castor2018/Rhino-Pi-A1-VisionGuidedCar/接线图/小车装配图2.jpg

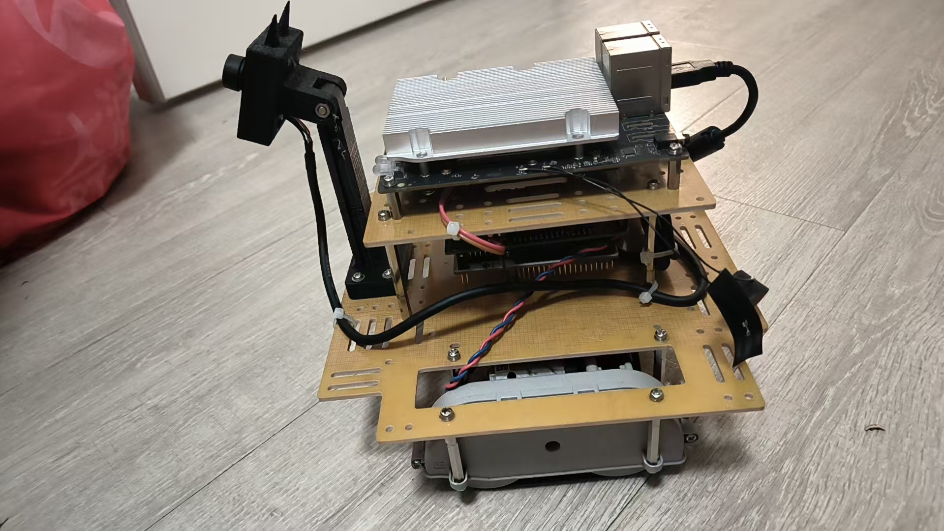
接线图/小车装配图2.jpg
