castor2018/Rhino-Pi-A1-VisionGuidedCar/接线图/STM32开发板.png

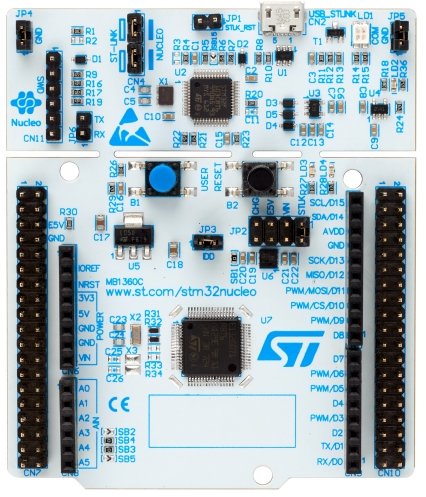
接线图/STM32开发板.png
