castor2018/Rhino-Pi-A1-VisionGuidedCar/接线图/摄像头.png

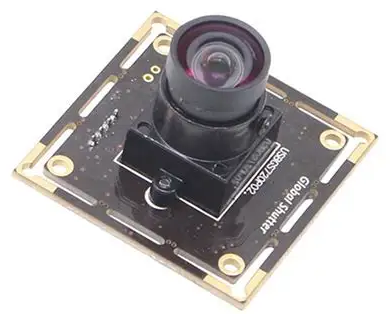
接线图/摄像头.png
