castor2018/Rhino-Pi-A1-VisionGuidedCar/接线图/犀牛派.png

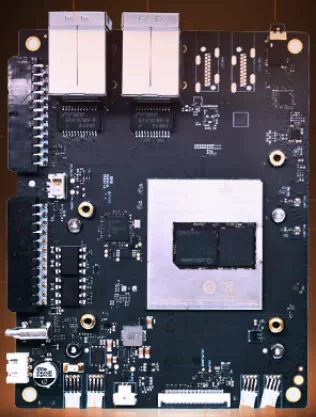
接线图/犀牛派.png
