castor2018/Rhino-Pi-A1-VisionGuidedCar/接线图/电机驱动板.png

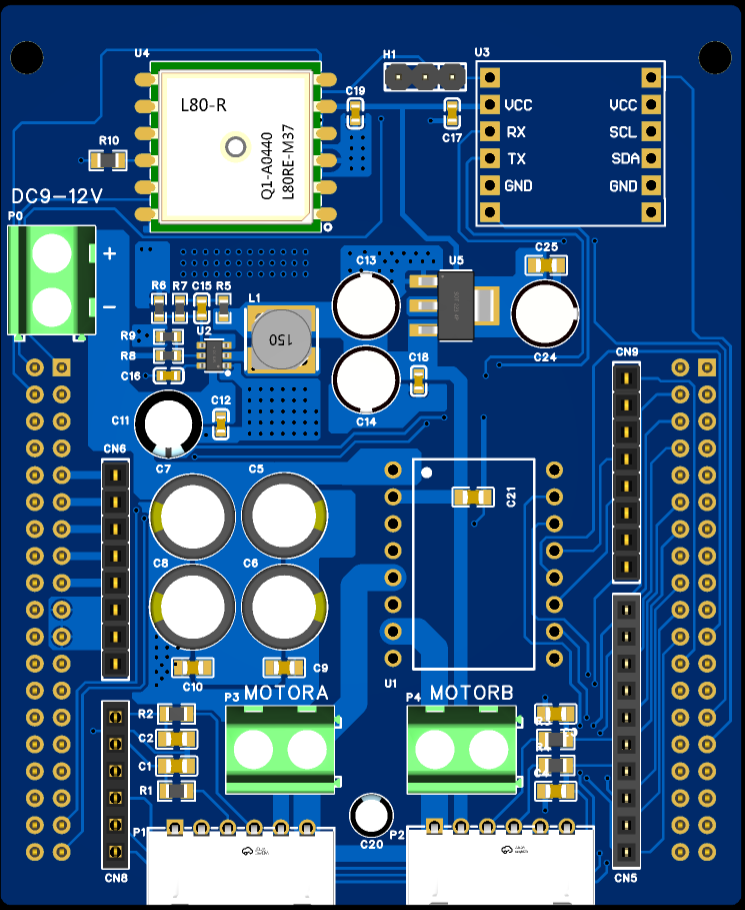
接线图/电机驱动板.png
