castor2018/Rhino-Pi-A1-VisionGuidedCar/接线图/电池png.png

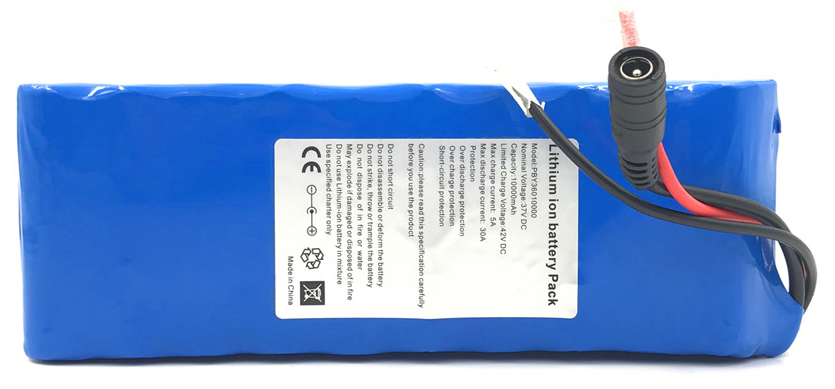
接线图/电池png.png
