castor2018/Rhino-Pi-A1-VisionGuidedCar/接线图/系统接线图.png

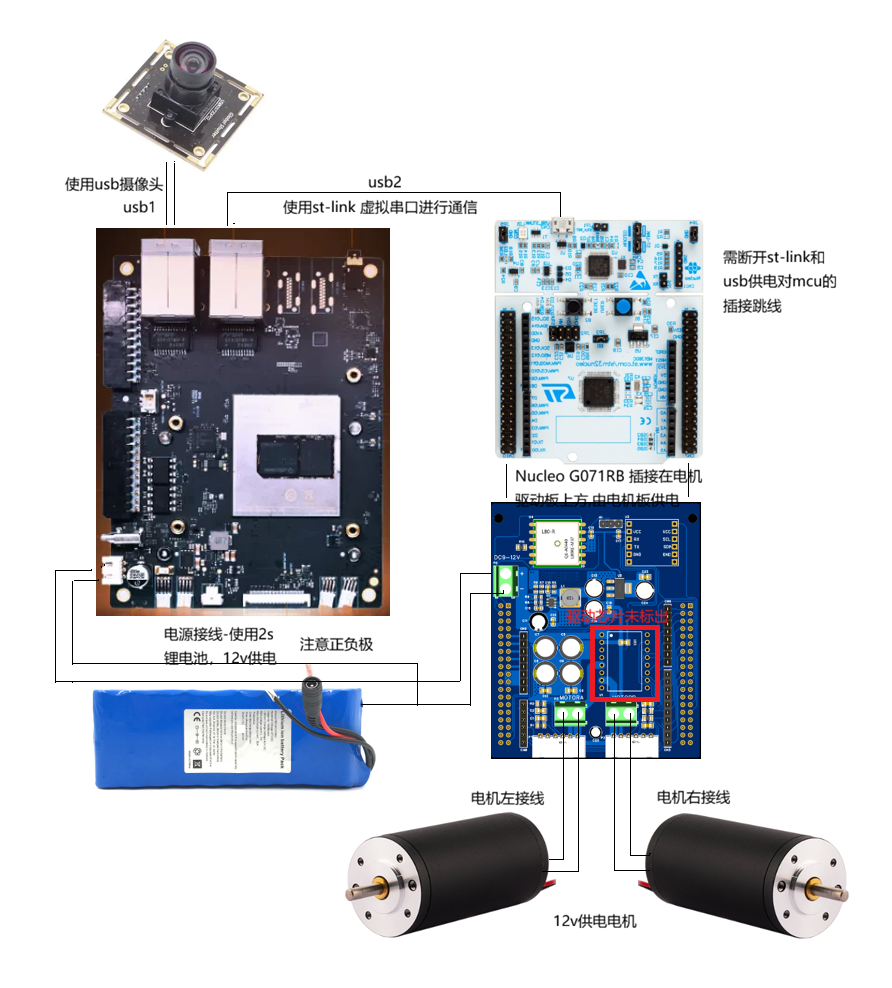
接线图/系统接线图.png
