castor2018/Rhino-Pi-A1-VisionGuidedCar/视觉控制算法程序/aid-Car/object_det/cover.png

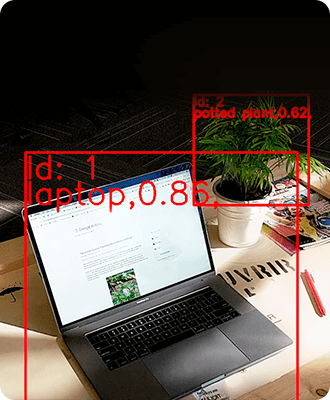
视觉控制算法程序/aid-Car/object_det/cover.png
