castor2018/Rhino-Pi-A1-VisionGuidedCar/视觉控制算法程序/aid-Car/plate_spot/img/6.jpg

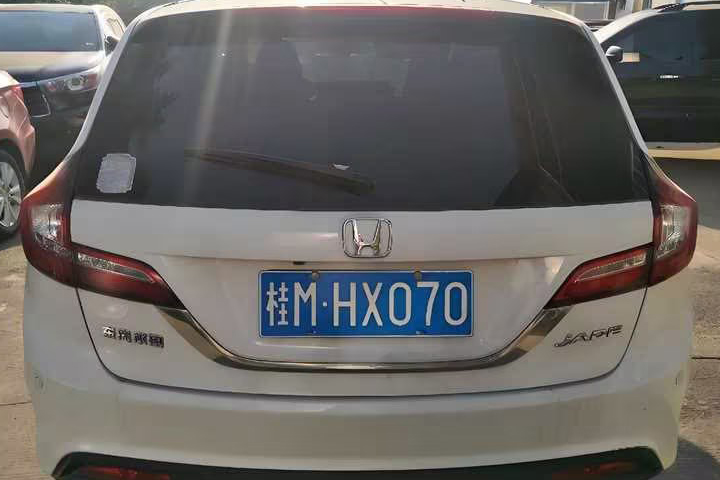
视觉控制算法程序/aid-Car/plate_spot/img/6.jpg
