castor2018/Rhino-Pi-A1-VisionGuidedCar/电机驱动板原理图/电机驱动板V1.0.xlsx

No. | Quantity | Comment | Designator | Footprint | Value
1 | 9 | 100nF | C1,C2,C3,C4,C9,C10,C21,C22,C25 | C0805 | 100nF
2 | 4 | 100uF | C5,C6,C7,C8 | CAP-TH_BD8.0-P3.50-D0.5-FD | 100uF
3 | 1 | 47uF/35V | C11 | CAP-TH_BD6.3-P2.50-D1.0-FD | 47uF/35V
4 | 5 | 100nF | C12,C16,C17,C18,C19 | C0603 | 100nF
5 | 3 | 22uF/25V | C13,C14,C24 | CAP-TH_BD6.3-P2.50-D0.6-FD | 22uF/25V
6 | 1 | 75pF | C15 | C0603 | 75pF
7 | 1 | 4.7uF | C20 | CAP-TH_BD4.0-P1.50-D0.8-FD | 4.7uF
8 | 1 | HDR-F_2.54_1x10P | CN5 | HDR-TH_10P-P2.54-V-F
9 | 2 | HDR-F_2.54_1x8P | CN6,CN9 | HDR-TH_8P-P2.54-V-F-1
10 | 2 | HC-PM254-8.5H-2x19PZ | CN7,CN10 | HDR-TH_38P-P2.54-V-F-R2-C19-S2.54
11 | 1 | HDR-F_2.54_1x6P | CN8 | HDR-TH_6P-P2.54-V-F
12 | 1 | HDR-M_2.54_1x3P | H1 | HDR-TH_3P-P2.54-V-M
13 | 1 | 10uH | L1 | IND-SMD_L5.7-W5.7 | 10uH
14 | 3 | KF127-5.08-2P | P0,P3,P4 | CONN-TH_P5.08_KF127-5.08-2P
15 | 2 | ZX-XH2.54-6PWZ | P1,P2 | CONN-TH_6P-P2.50_ZX-XH2.54-6PWZ
16 | 5 | 1kΩ | R1,R2,R3,R4,R10 | R0805 | 1kΩ
17 | 1 | 49.9R | R5 | R0603 | 49.9R
18 | 1 | 13.3K | R6 | R0603 | 13.3K
19 | 2 | 100K | R7,R9 | R0603 | 100K
20 | 1 | 500K | R8 | R0603 | 500K
21 | 2 | 0R | R11,R12 | R0603 | 0R
22 | 1 | tb6612驱动板 | U1 | tb6612电机驱动模块 | 淘宝
23 | 1 | TPS54302DDCR | U2 | TSOT-23-6_L2.9-W1.6-P0.95-LS2.8-BR
24 | 1 | JY-901 | U3 | JY-901 | 维特智能
25 | 1 | L80-R | U4 | GPSM-SMD_L80-R | 移远
26 | 1 | AMS1117-3.3 | U5 | SOT-223-3_L6.5-W3.4-P2.30-LS7.0-BR
