castor2018/Rhino-Pi-A1-VisionGuidedCar/材料清单.docx

犀牛派A1项目视觉跟随小车材料清单

序号 | 名称 | 型号 | 数量 | 单位 | 备注
1 | 视觉核心板 | 犀牛派A1 | 1 | 个 | 完成视觉算法
2 | 驱动核心板 | NUCELO-G071RB | 1 | 个 | 完成运动指令接收
3 | 电机驱动板 | | 1 | 个 | 接收驱动核心板指令驱动电机
4 | 履带式电机 | 12V | 1 | 对 | 淘宝
5 | USB摄像头 | DCXGW10模组-无畸变 | 1 | 个 | 杰锐微通
6 | 3S锂电池组 | 11.1V锂电池 3A | 1 | 个
7 | MicroUSB线 | | 1 | 个
8 | 框架板 | | 2 | 个 | 环氧树脂或亚克力
9 | M3-六棱柱 | | 8 | 个
10 | M3-六棱柱 | | 4 | 个
11 | M3-六棱柱 | | 4 | 个
12 | 摄像头支架 | | 1 | 套 | 3D打印件，可不用
13
14
15 | 扎带 | | | 个
16 | M3螺丝 | | | 若干
