castor2018/Rhino-Pi-A1-VisionGuidedCar/摄像头支架/摄像头支架.3mf

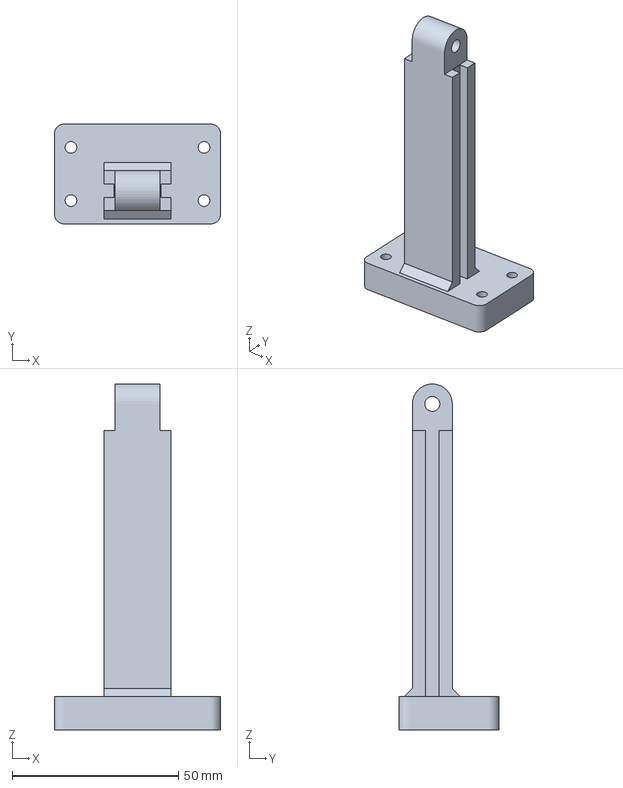
[picture p19: CAD file, 2026-09-28]
摄像头支架/摄像头支架.3mf
50.0 x 30.0 x 104.0 mm
