castor2018/Rhino-Pi-A1-VisionGuidedCar/小车框架基板/上板.STEP

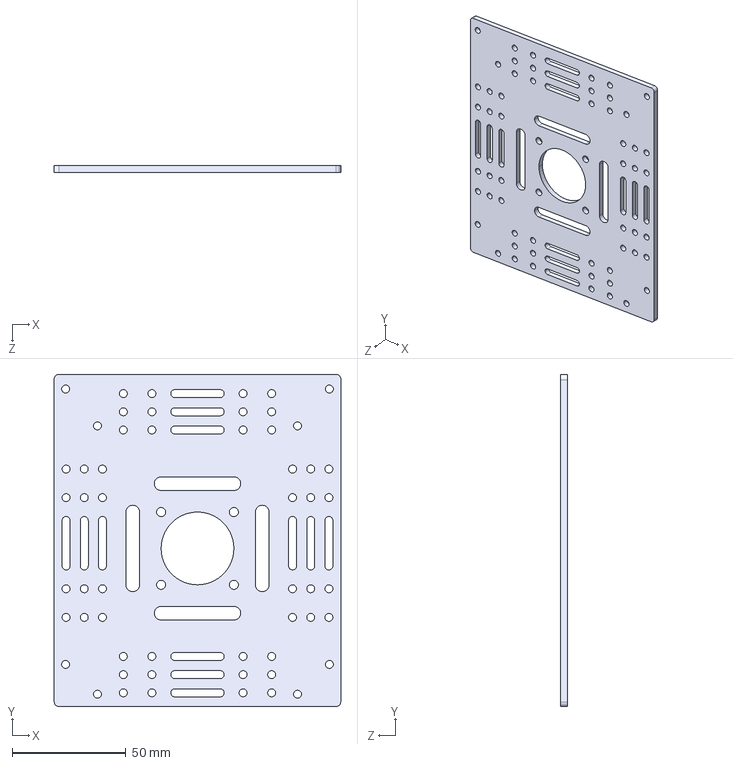
[picture p20: CAD file, 2026-09-28]
小车框架基板/上板.STEP
126.1 x 146.0 x 3.00 mm
