castor2018/Rhino-Pi-A1-VisionGuidedCar/摄像头支架/摄像头外壳.3mf

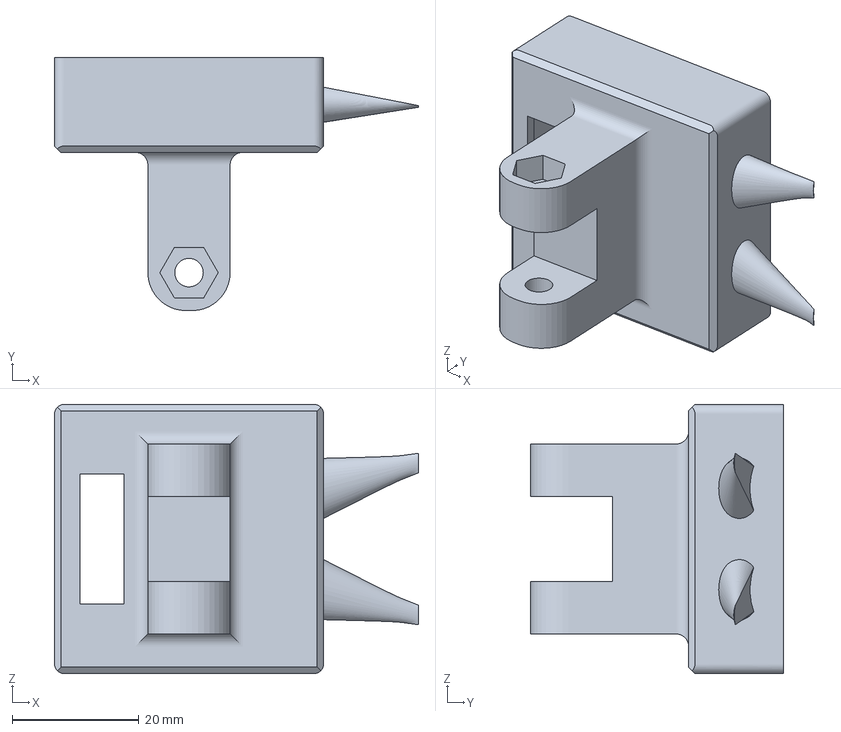
[picture p21: CAD file, 2026-09-28]
摄像头支架/摄像头外壳.3mf
57.5 x 40.0 x 42.5 mm
