castor2018/Rhino-Pi-A1-VisionGuidedCar/摄像头支架/摄像头顶盖.3mf

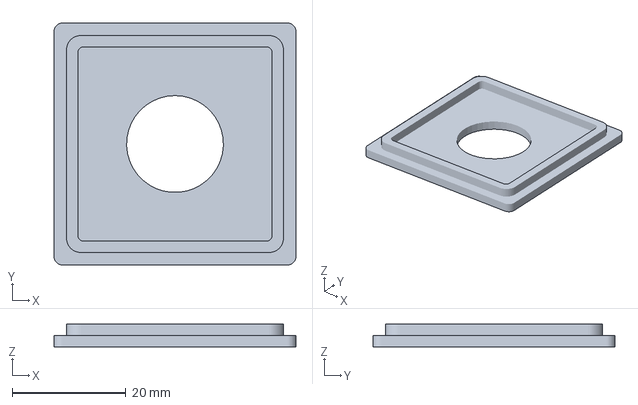
[picture p22: CAD file, 2026-09-28]
摄像头支架/摄像头顶盖.3mf
42.5 x 42.5 x 4.00 mm
