castor2018/Rhino-Pi-A1-VisionGuidedCar/小车框架基板/下板.STEP

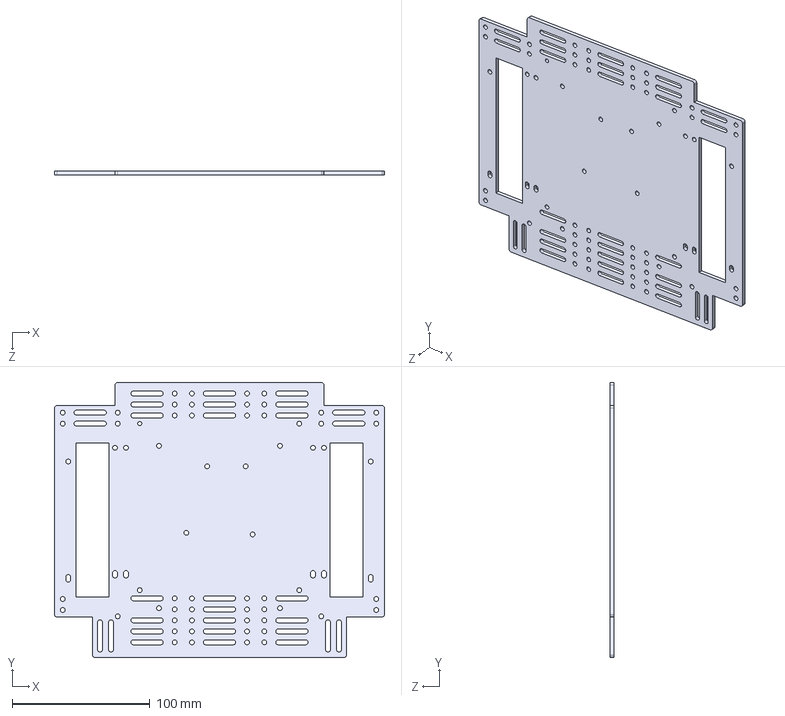
[picture p23: CAD file, 2026-09-28]
小车框架基板/下板.STEP
240.0 x 200.0 x 3.00 mm
