castor2018/Rhino-Pi-A1-VisionGuidedCar/(list of files, cad)

Other CAD files:
小车框架基板/下板_2004.dwg
小车框架基板/上板_2004.dwg
