castor2018/Rhino-Pi-A1-VisionGuidedCar/电机驱动板原理图/电机驱动板V1.0.pdf

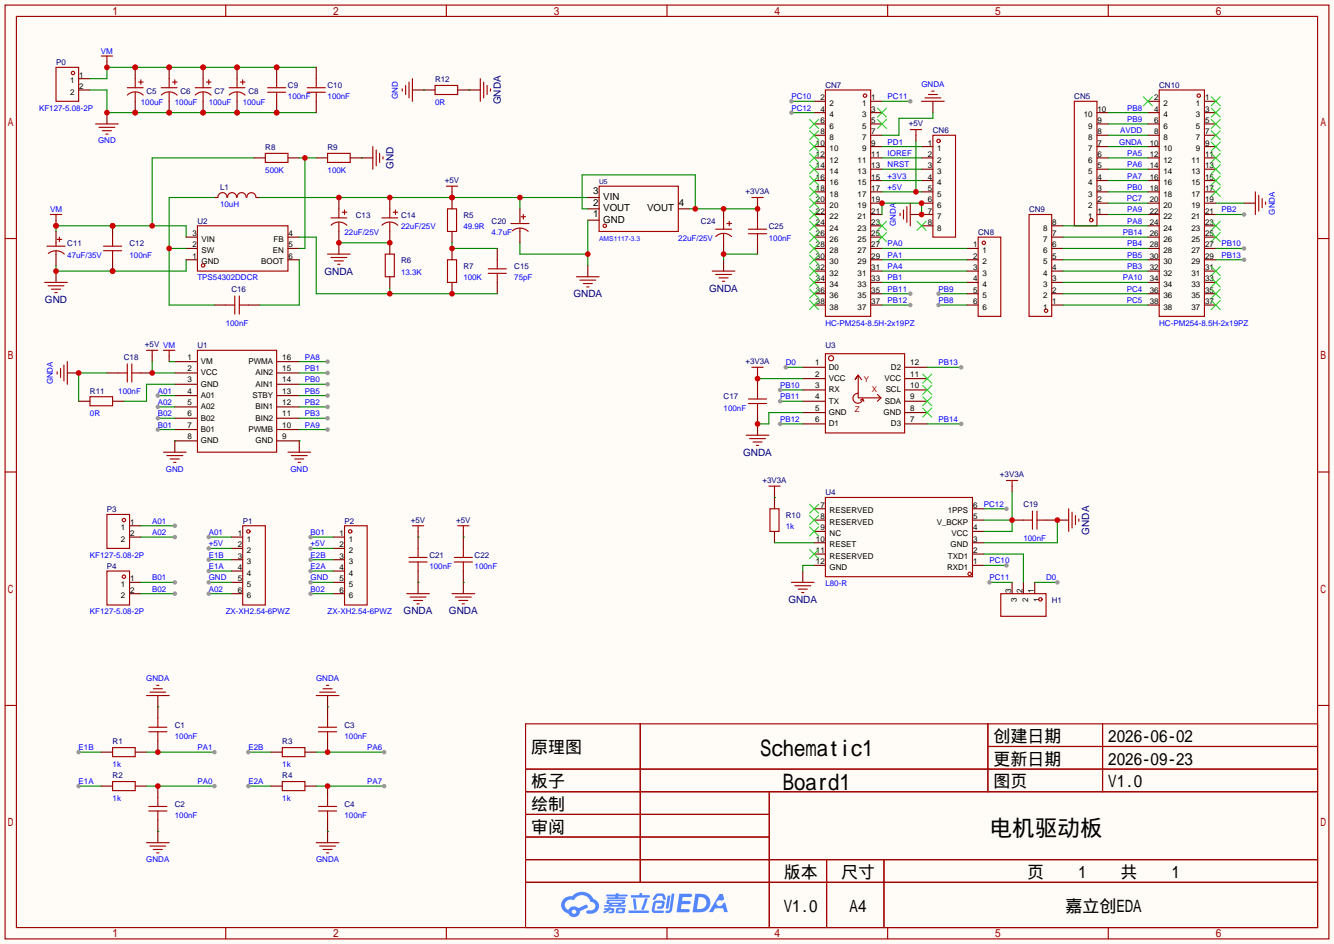
[picture p24: page 1]

原理图 | Schematic1 | 创建日期 | 2026-06-02

更新日期 | 2026-09-23

板子 | Board1 | 图页 | V1.0
绘制 | | 电机驱动板
审阅

V1.0 | A4 | 嘉立创EDA
