castor2018/Rhino-Pi-A1-VisionGuidedCar/电机驱动程序/diy_TrackCar/Core/Inc/main.h

#define MCO_Pin GPIO_PIN_0
#define MCO_GPIO_Port GPIOF
#define USART2_TX_Pin GPIO_PIN_2
#define USART2_TX_GPIO_Port GPIOA
#define USART2_RX_Pin GPIO_PIN_3
#define USART2_RX_GPIO_Port GPIOA
#define LED_GREEN_Pin GPIO_PIN_5
#define LED_GREEN_GPIO_Port GPIOA
#define LEFT_WHELL_IN0_Pin GPIO_PIN_0
#define LEFT_WHELL_IN0_GPIO_Port GPIOB
#define LEFT_WHELL_IN1_Pin GPIO_PIN_1
#define LEFT_WHELL_IN1_GPIO_Port GPIOB
#define RIGHT_WHELL_IN0_Pin GPIO_PIN_2
#define RIGHT_WHELL_IN0_GPIO_Port GPIOB
#define TMS_Pin GPIO_PIN_13
#define TMS_GPIO_Port GPIOA
#define TCK_Pin GPIO_PIN_14
#define TCK_GPIO_Port GPIOA
#define RIGHT_WHELL_IN1_Pin GPIO_PIN_3
#define RIGHT_WHELL_IN1_GPIO_Port GPIOB
#define WHELL_STBY_Pin GPIO_PIN_5
#define WHELL_STBY_GPIO_Port GPIOB
