castor2018/Rhino-Pi-A1-VisionGuidedCar/电机驱动程序/diy_TrackCar/Core/Inc/drv_usart2_poll.h

/*
 * drv_usart2_poll.h
 *
 *  Created on: 2026年9月3日
 *      Author: 27059
 */

#ifndef INC_DRV_USART2_POLL_H_
#define INC_DRV_USART2_POLL_H_


/*
 * drv_usart2_poll.c
 *
 *  Created on: 2026年9月3日
 *      Author: 27059
 */

#include "stm32g0xx_hal.h"
void USART2_Poll_Parse(UART_HandleTypeDef *huart2);
#endif /* INC_DRV_USART2_POLL_H_ */
