castor2018/Rhino-Pi-A1-VisionGuidedCar/(commit log)

2026-09-28 犀牛派A1机器人小车 初始版本代码
2026-09-28 docs: add README per case-collection spec
2026-09-29 feat:update readme/电机驱动板V1.0.zip
2026-09-29 add:小车装配图
2026-10-14 更新readme.md，修复说明文字/更新run_object_det.py
