castor2018/Rhino-Pi-A1-VisionGuidedCar/(notices)

Notices in the files:
电机驱动程序/diy_TrackCar/Core/Inc/main.h:
Copyright (c) 2026 STMicroelectronics.
All rights reserved.
This software is licensed under terms that can be found in the LICENSE file
